matthewg42/MiniPredictionMachines/doc/mpm_parts.svg.png

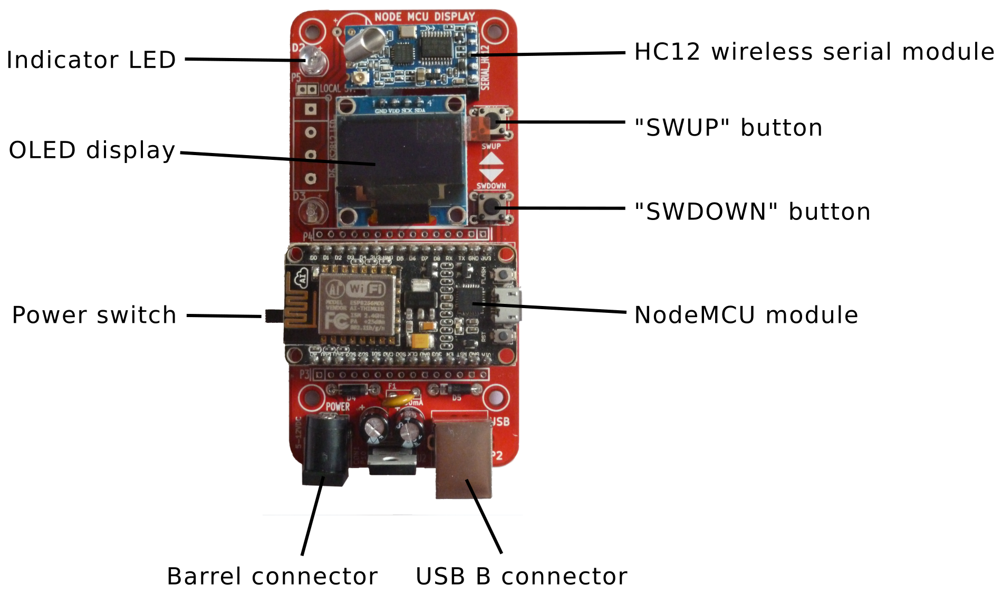
doc/mpm_parts.svg.png
