matthewg42/MiniPredictionMachines/doc/mpm.png

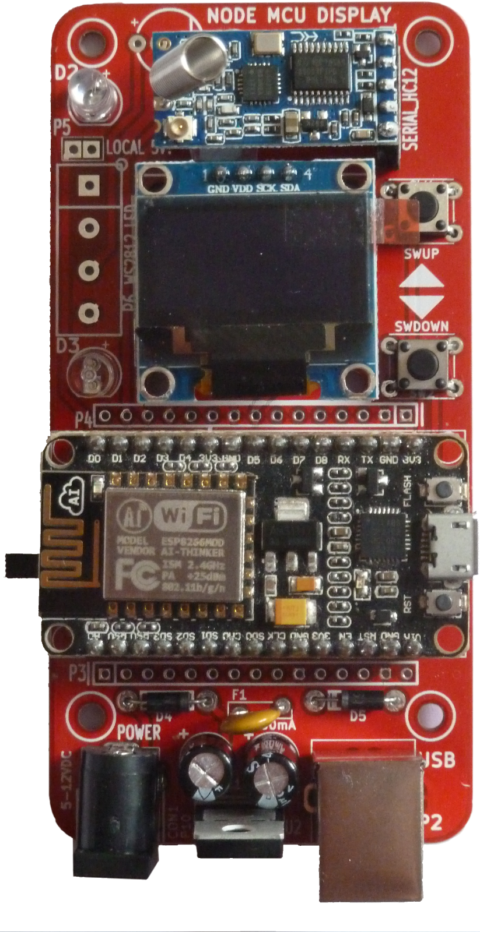
doc/mpm.png
