matthewg42/MiniPredictionMachines/src/testing_api/README.md

Here is a very simplistic HTTP API for testing the mpm unit with.  It will run locally.
