matthewg42/MiniPredictionMachines/doc/mpm_schematic.pdf

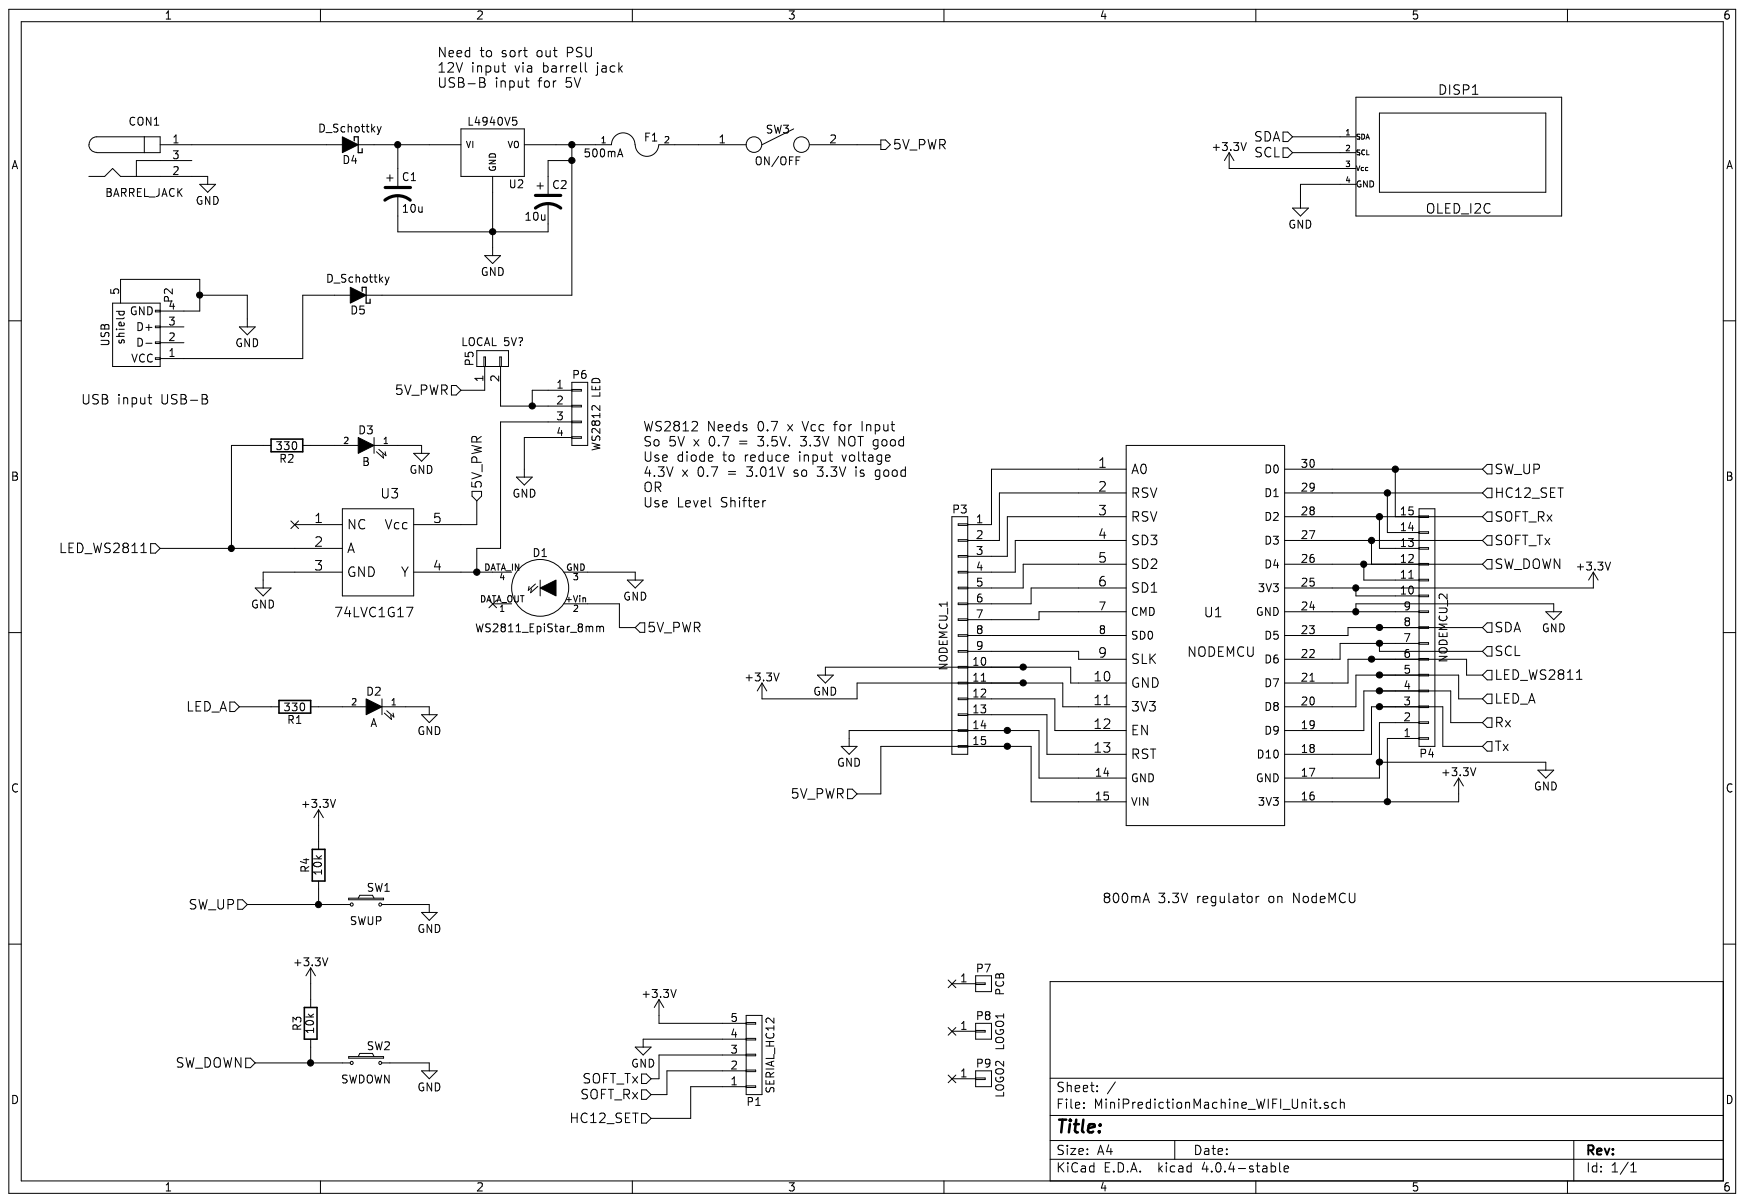
[picture p3: page 1]
