matthewg42/MiniPredictionMachines/doc/weathers_station_schematic.pdf

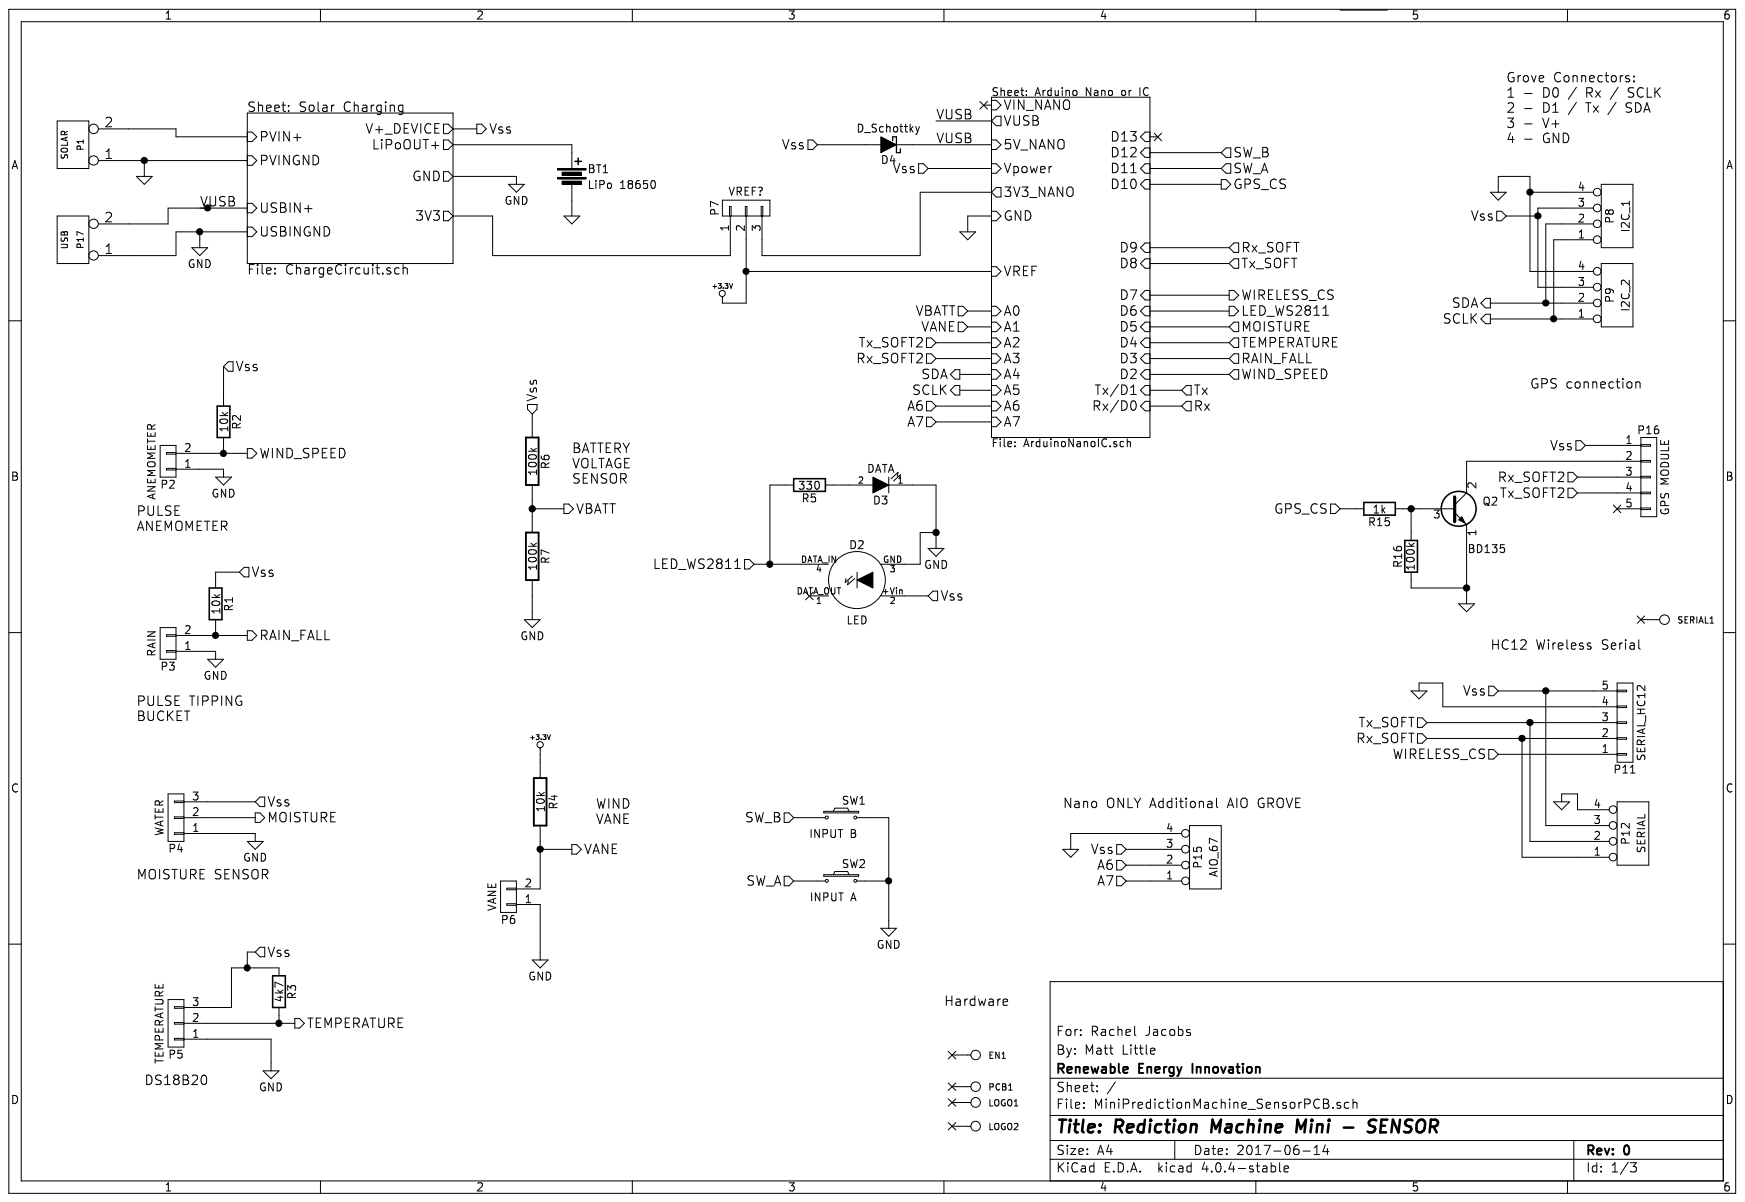
[picture p4: page 1]

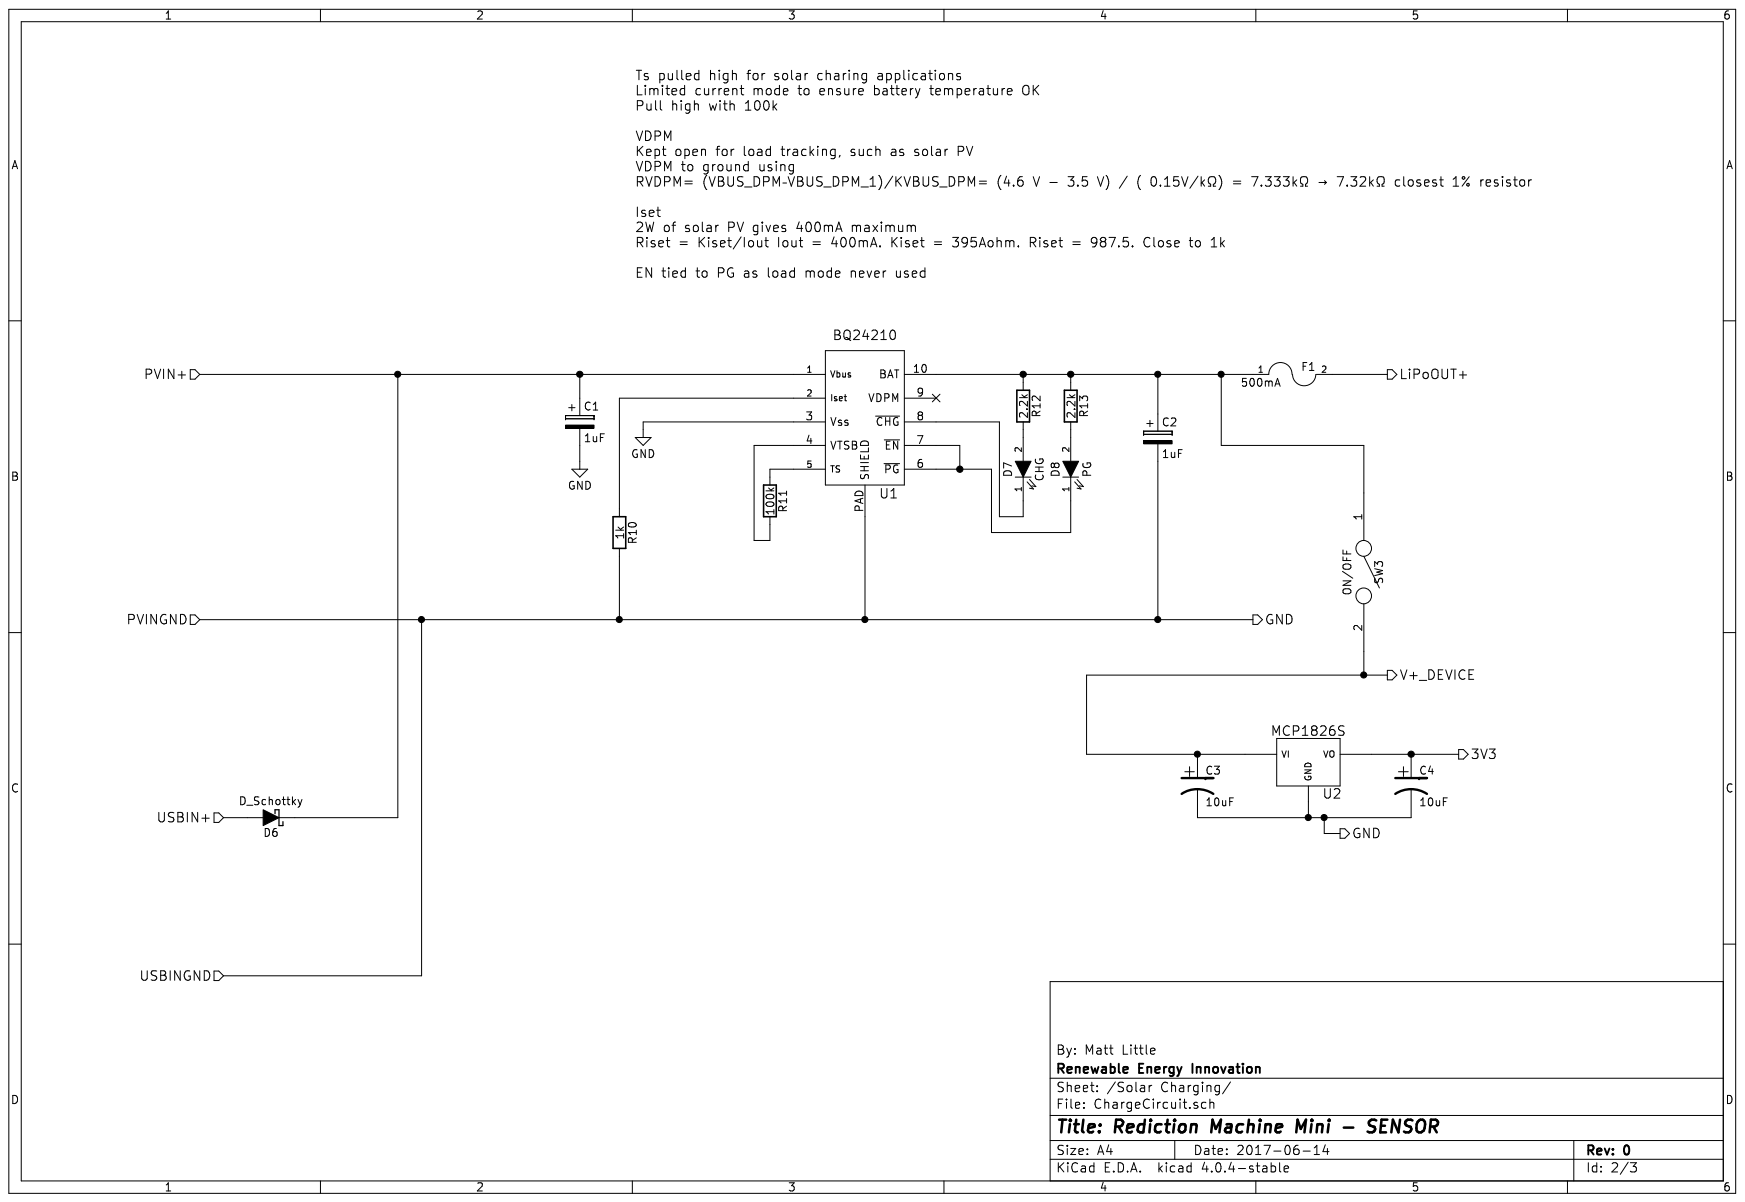
[picture p5: page 2]

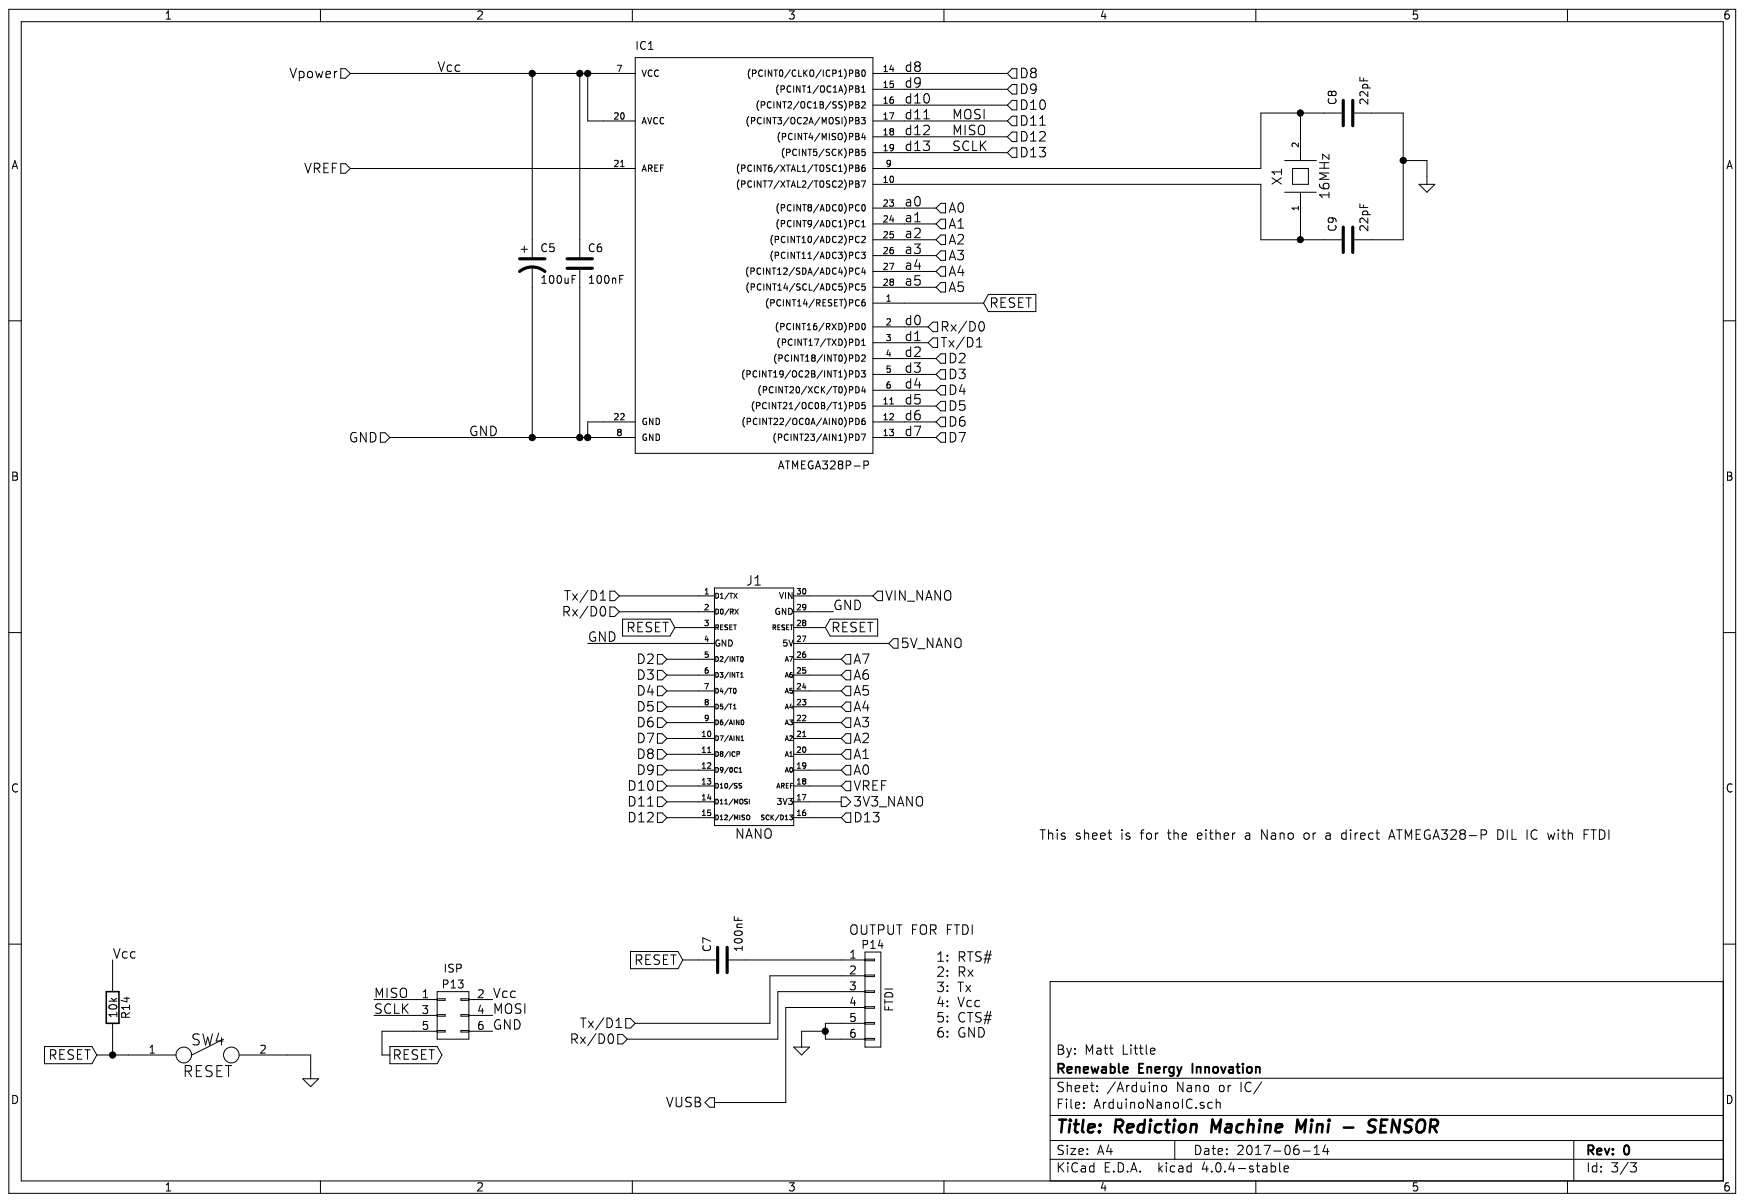
[picture p6: page 3]
