matthewg42/MiniPredictionMachines/doc/mpm_pcb.pdf

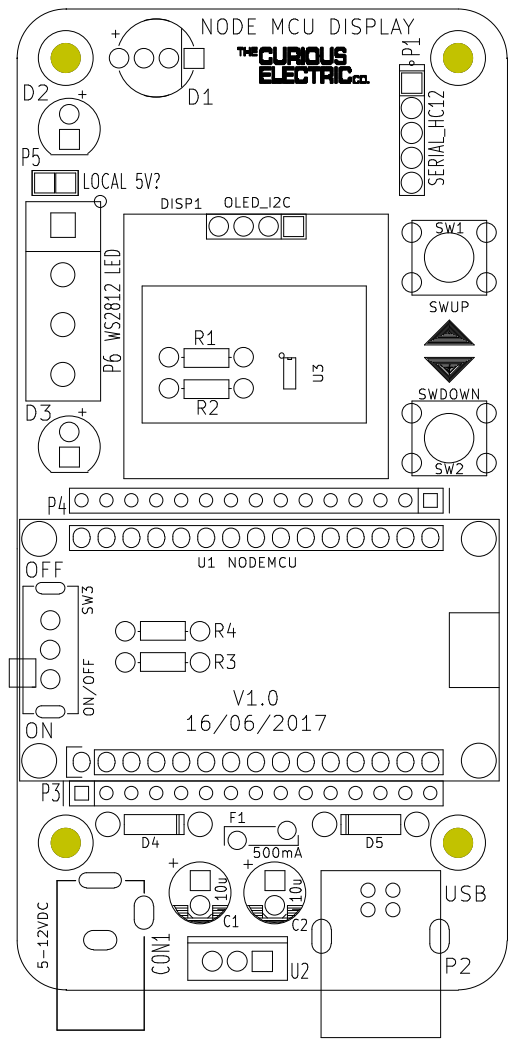
[picture p7: page 1]
