matthewg42/MiniPredictionMachines/doc/Prediction WIFI.pdf

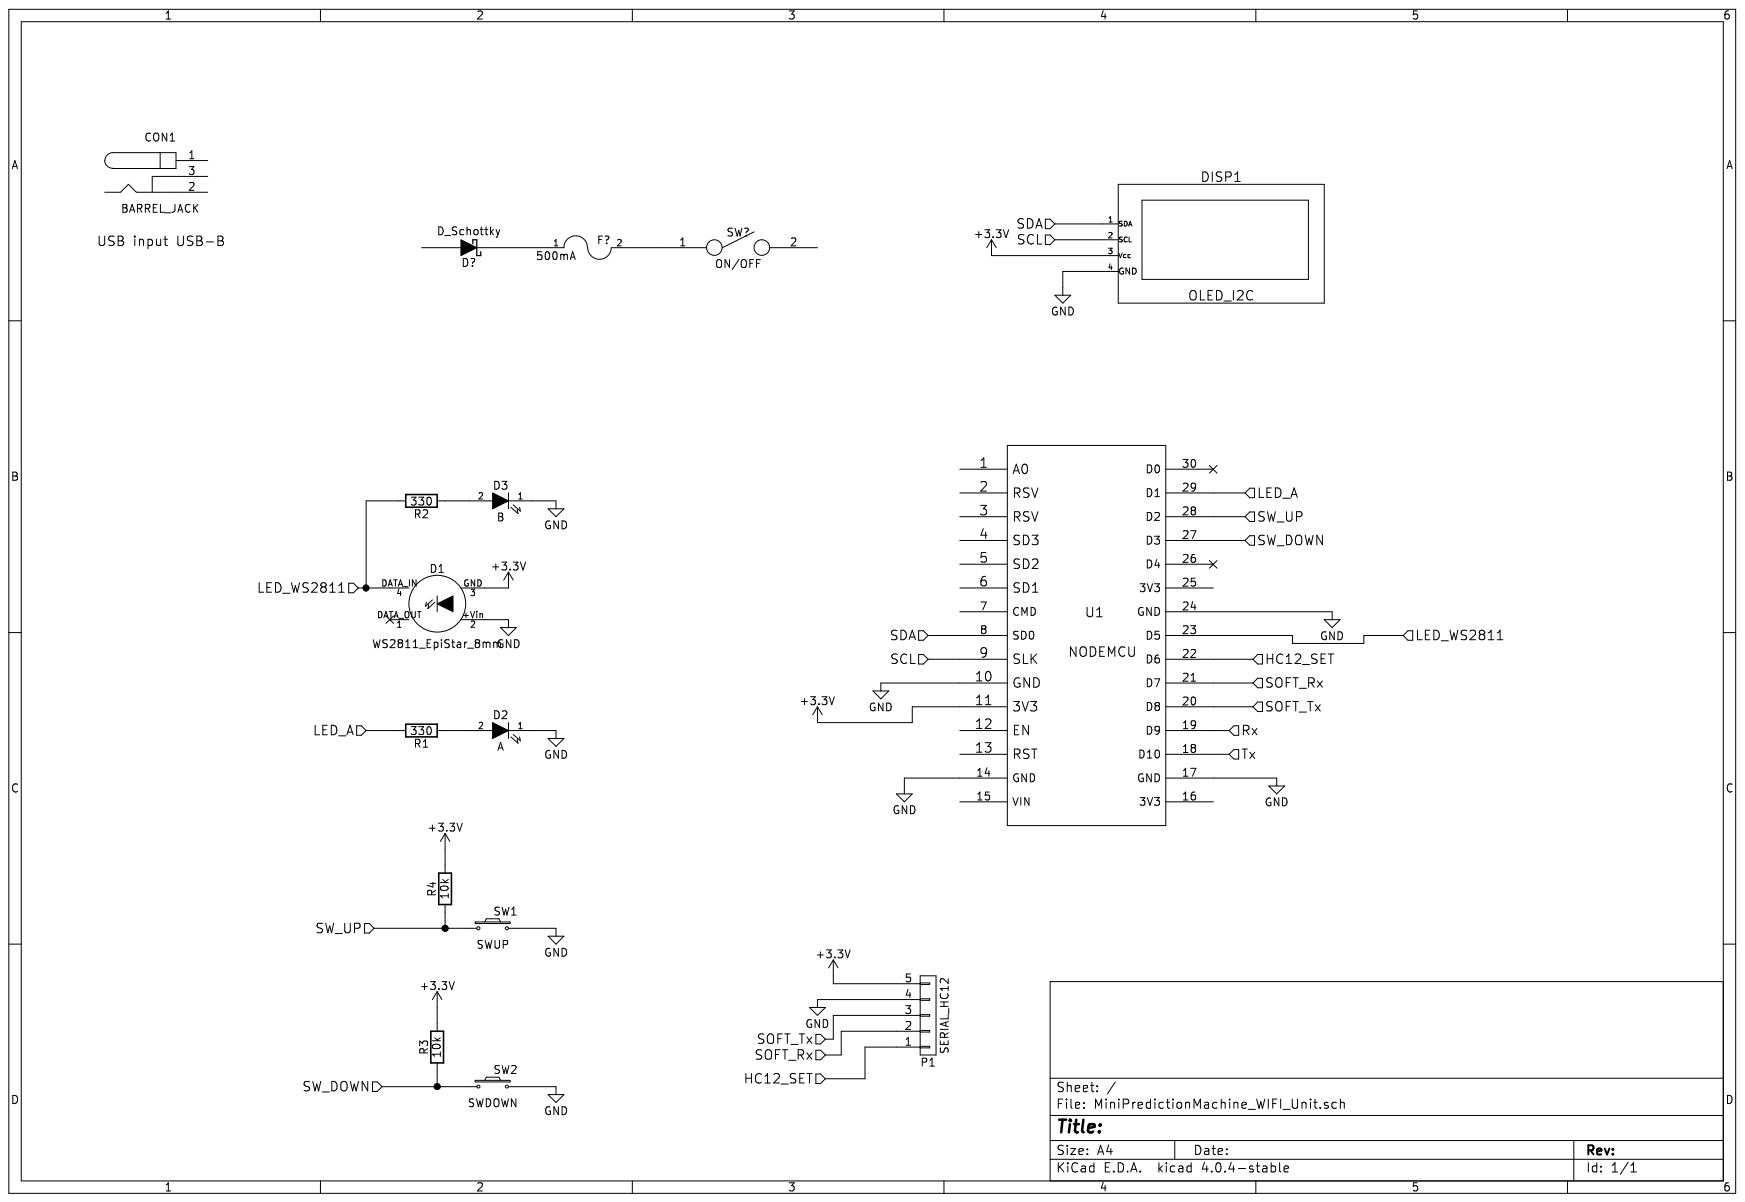
[picture p8: page 1]
