matthewg42/MiniPredictionMachines/src/mpm/mpm.ino

#include <EEPROM.h>
#include <Mode.h>
#include <MutilaDebug.h>
#include <ESP8266WebServer.h>
#include <ESP8266WiFi.h>
#include <ESP8266HTTPClient.h>
#include <PersistentSettingFloat.h>
#include <PersistentSettingString.h>
#include <EspApConfigurator.h>
#include <ModeWifiClient.h>
#include <SoftwareSerial.h>
#include <U8g2lib.h>
#include <SPI.h>
#include <Wire.h>
#include <TimeLib.h>
#include <Crypto.h>

// Physical devices
#include "HC12Serial.h"
#include "OLED.h"
#include "SWDOWN.h"

// Modes
#include "ModeWeather.h"
#include "ModeRealTime.h"

// Other
#include "EspID.h"
#include "Config.h"

void setup() 
{
    DBBEGIN;
    delay(50);
    DBLN(F("\n\nS:setup"));
    
    // Set ID based on mac address
    EspID.begin();

    // Initialize OLED and choose a font
    OLED.begin();
    OLED.clearBuffer();
    String s(F("Mini Prediction Machine ID: "));
    s += EspID.get();
    OLED.displayText(s.c_str(), 'C', 'M');

    HC12Serial.begin();
    delay(100);

    SWDOWN.begin();

    ModeWeather.begin();
    ModeRealTime.begin();
    EspApConfigurator.begin(SW_UP_PIN, HEARTBEAT_PIN, HEARTBEAT_INV);
    String apModeName = "MiniPredictionMachine_";
    apModeName += EspID.get();
    EspApConfigurator.setApDetails(apModeName.c_str(), AP_PASSPHRASE);

    // Enable web server in ModeWifiClient - this just makes testing
    // easier as I don't have to keep connecting to the AP to see
    // how the interface is being rendered...
    //ModeWifiClient.enableHttpServer(true);
    EspApConfigurator.addSetting(SET_NTP_SERVER, new PersistentSettingString(EspApConfigurator.nextFreeAddress(), 64, "time.google.com"));
    EspApConfigurator.addSetting(SET_LATITUDE,   new PersistentSettingFloat(EspApConfigurator.nextFreeAddress(), 0, 5));
    EspApConfigurator.addSetting(SET_LONGITUDE,  new PersistentSettingFloat(EspApConfigurator.nextFreeAddress(), 0, 5));

    DBLN(F("E:setup"));
}

void loop() 
{
    // Give timeslice to components
    EspApConfigurator.update();
    ModeRealTime.update();
    ModeWeather.update();
}
