matthewg42/MiniPredictionMachines/src/oled_test/Config.h

#pragma once

#include <Arduino.h>

#define OLED_MESSAGE_FONT u8g2_font_helvR08_tf
const uint8_t OLED_SCK_PIN              = D6;
const uint8_t OLED_SDA_PIN              = D5;
const uint8_t OLED_MESSAGE_FONT_HEIGHT  = 8;
const uint8_t OLED_MESSAGE_FONT_VSEP    = 3;
