matthewg42/MiniPredictionMachines/(commit log)

2017-06-15 NTP doesn't need to be so frequent
    [Config.h]
2017-06-24 Arduino build file
2017-06-24 temperature reading
2017-06-24 add moisture sensor
2017-06-24 move temperature into class of it's own
2017-06-24 Interrupt on wind pulse
    Notes:
    * The device doesn't seem to need debouncing
    * The Millis() measurement doesn't increase while in sleep mode
    * Interupts should do their thing really quick and exit - just setting a
    flag and letting the main loop to work is a good call.
    [weather_station.ino]
2017-06-25 timer working with min sleep
2017-06-25 wake up with watchdog (more power save)
2017-06-26 All sensor reading
    However, I'm getting unexpected readings of rainfall sensor.
    I don't see the pin going high at all with a multi-meter (might just not
    be quick enough to be seeing noise).
    Hopefully not an interaction with the watchdog timer.
    [Config.h, PulseCounter.cpp, PulseCounter.h, RainfallSensor.cpp, RainfallSensor.h, WindspeedSensor.cpp, weather_station.ino]
2017-06-26 use official way to get int id from pin
2017-06-26 prevent constant rainfall trigger
    [Config.h, PulseCounter.cpp, weather_station.ino]
2017-06-26 deal with spurious rain pulse on reset
    [weather_station.ino]
2017-06-27 move pin mode to begin arg (save variable)
2017-06-28 how to calculate rainfall sensor
2017-06-30 correct calculation of wind speed
    [WindspeedSensor.cpp]
2017-06-30 Crc16 doesn't need to depend on Arduino libs
    [Crc16.h]
2017-07-01 include battery voltage in data
2017-07-01 use asynchronous temperature fetch
2017-07-03 HC12 power saving; duty cycle in data
2017-07-03 add testing API framework
2017-07-12 correct decoding of current_message response
    [ModeWeather.cpp]
2017-07-12 fix rainfall aging bug
    [RainfallSensor.cpp]
2017-07-13 ugly, but calculates SOME hmac (correct?)
    [HttpParamizer.cpp, HttpParamizer.h, ModeWeather.cpp, TimestreamsApiKey.h, mpm.ino]
2017-07-14 update TODO list from playing with boards
2017-07-14 tx/rx pin swap for actual PCB; use ts URL
    [Config.h]
2017-07-14 add battery voltage to display / cleanup display code
2017-07-15 fix rainfall history bug
    [RainfallSensor.cpp, RainfallSensor.h]
2017-07-15 control power of moisture sensor through GPS pin
2017-07-15 indicator LED on broadcast
2017-08-04 moisture sensor notes
